cese-dci/tp-pseverini84/Informacion/schOriginal.pdf

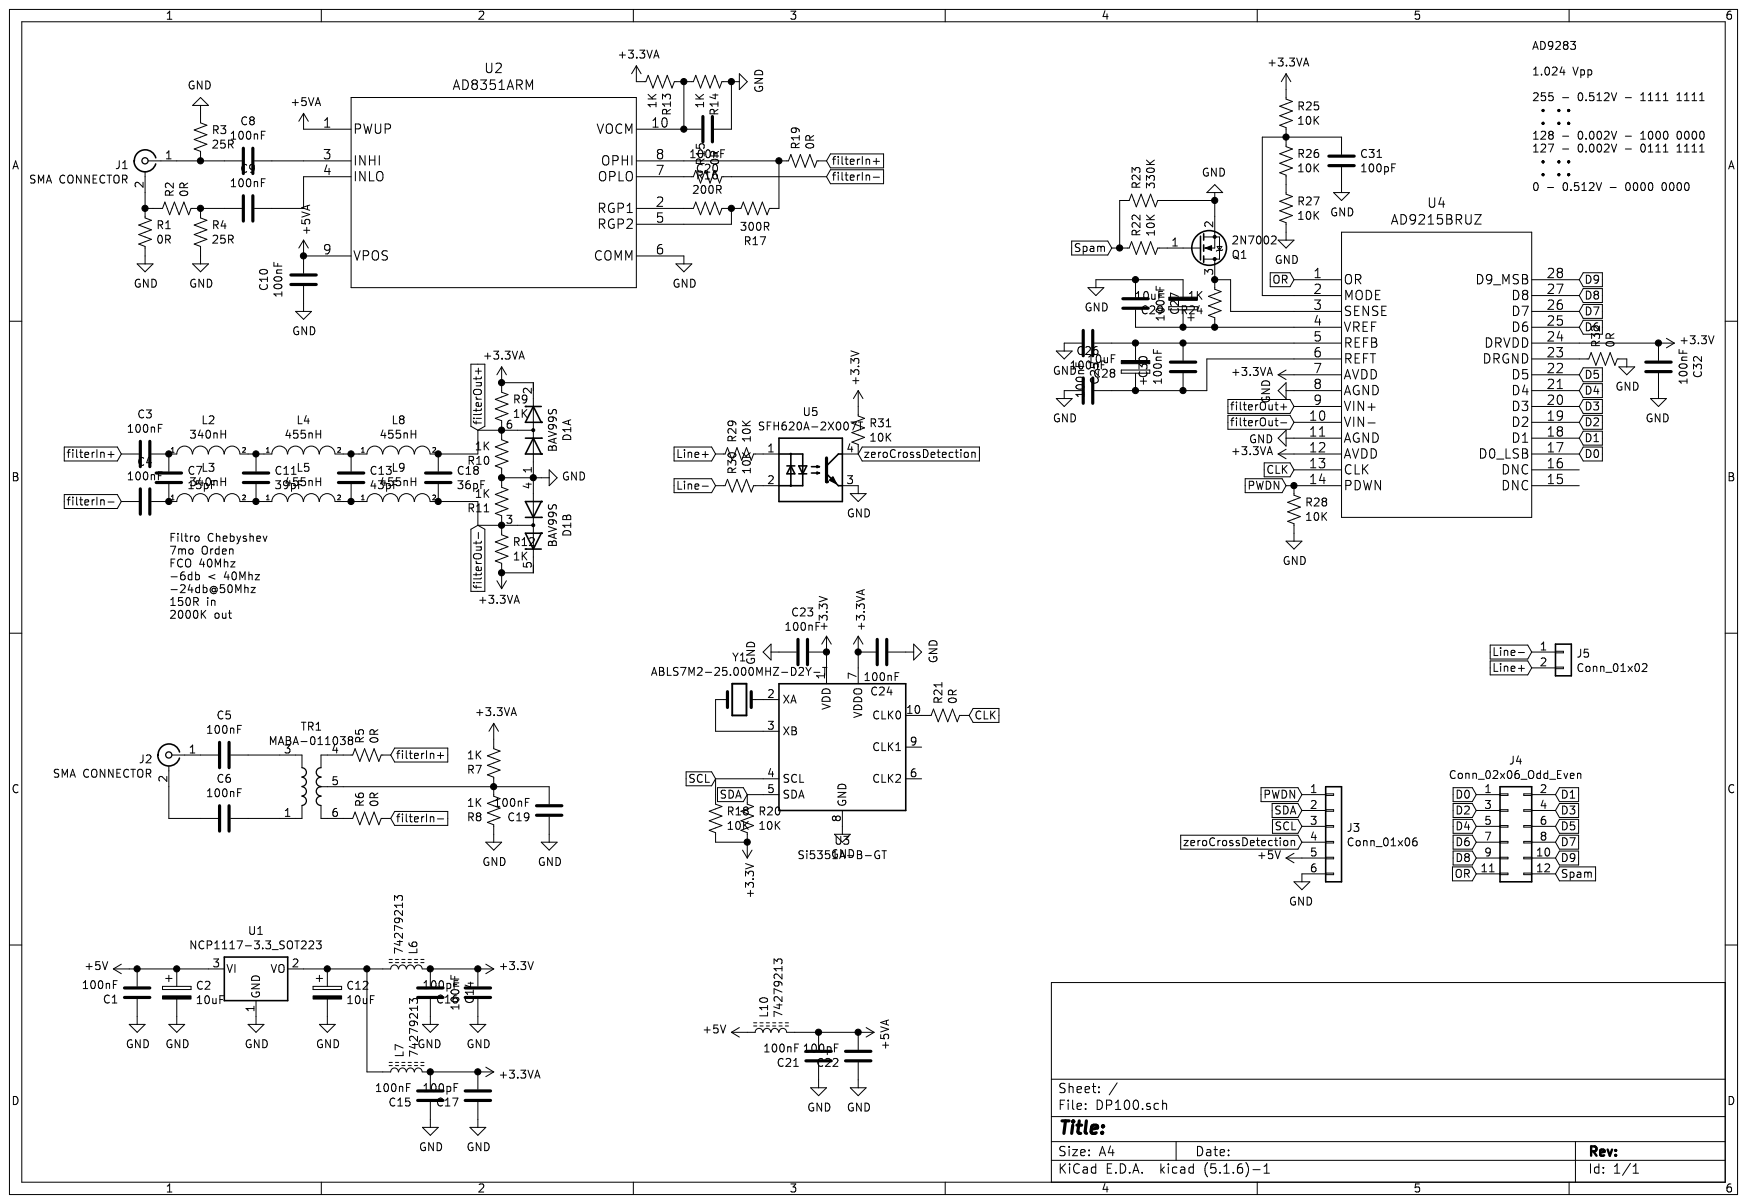
[picture p1: page 1]
