cese-dci/tp-pseverini84/DP100.kicad_pcb

## KiCad design DP100.kicad_pcb (2021-04-20)

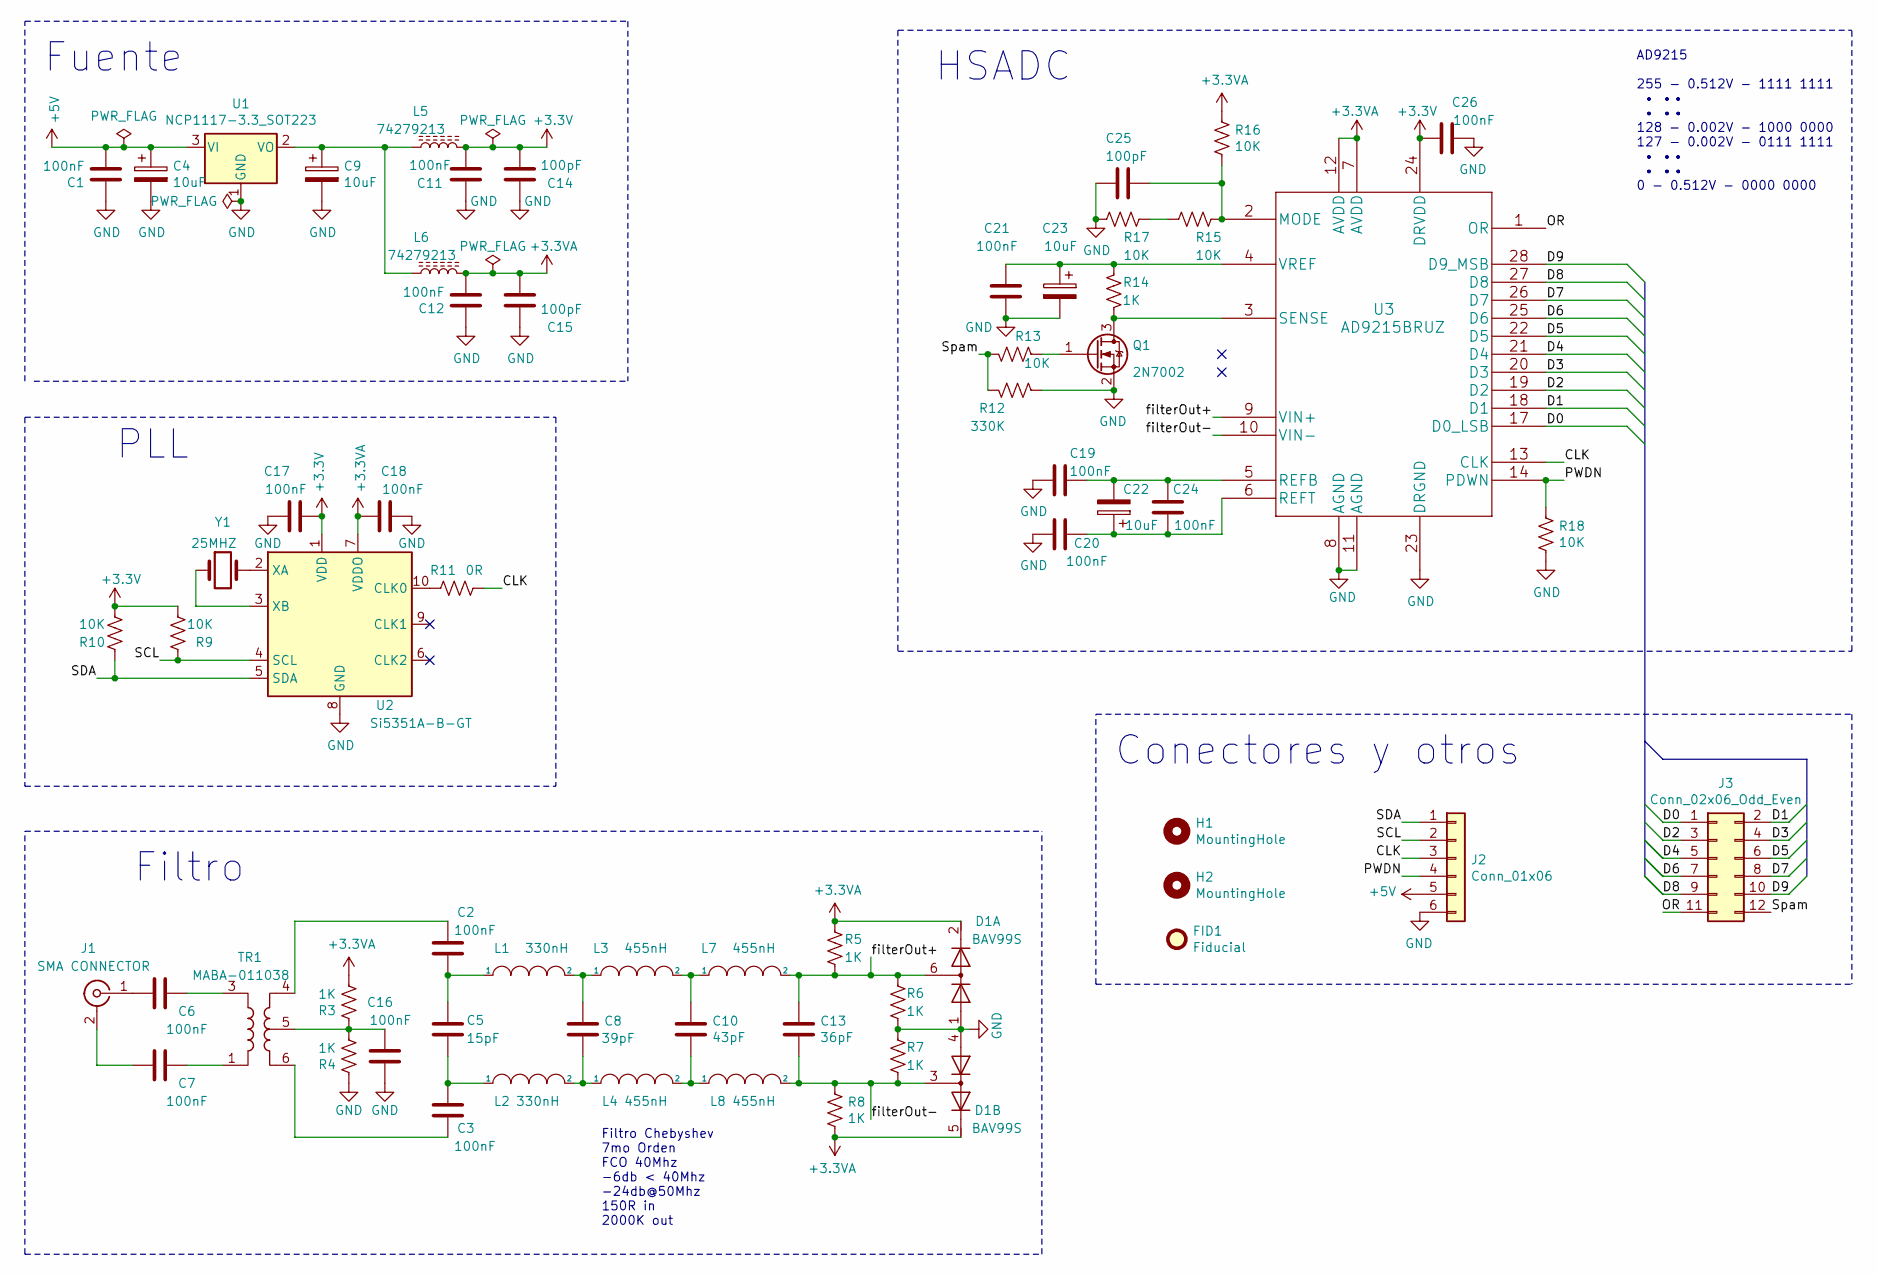
[picture p2: schematic DP100.sch, High speed ADC breakout]

Parts:
C1, C2, C3, C6, C7, C11, C12, C16, C17, C18, C19, C20, C21, C24, C26: 100nF; C_0603_1608Metric_Pad1.05x0.95mm_HandSolder; Mouser 80-C0603C104Z3V
C4, C9, C22, C23: 10uF; CP_EIA-2012-15_AVX-P_Pad1.30x1.05mm_HandSolder; Mouser 647-F920J106MPA
C5: 15pF; C_0603_1608Metric_Pad1.05x0.95mm_HandSolder; Mouser 710-885012006033
C8: 39pF; C_0603_1608Metric_Pad1.05x0.95mm_HandSolder; Mouser 80-C0603C390J5GAC
C10: 43pF; C_0603_1608Metric_Pad1.05x0.95mm_HandSolder; Mouser 603-CC603JRNPO9BN430
C13: 36pF; C_0603_1608Metric_Pad1.05x0.95mm_HandSolder; Mouser 603-CC603JRNPO9BN360
C14, C15, C25: 100pF; C_0603_1608Metric_Pad1.05x0.95mm_HandSolder; Mouser 80-C0603C101K1HACTU
D1: BAV99S; SOT-363_SC-70-6; Mouser 771-BAV99S-T/R
FID1: Fiducial; Fiducial_0.5mm_Mask1mm
H1, H2: MountingHole; MountingHole_3mm
J1: SMA CONNECTOR; SMA_Amphenol_901-144_Vertical; Mouser 471-SMARACONNECTOR
J2: Conn_01x06; PinHeader_1x06_P2.54mm_Vertical; Mouser 855-M20-9754046
J3: Conn_02x06_Odd_Even; PinHeader_2x06_P2.54mm_Vertical; Mouser 855-M20-9760642
L1, L2: 330nH; L_1206_3216Metric_Pad1.42x1.75mm_HandSolder; Mouser 963-LBM2016TR33JV
L3, L4, L7, L8: 455nH; L_0805_2012Metric_Pad1.15x1.40mm_HandSolder; Mouser 963-BRC1608TR45M
L5, L6: 74279213; C_1206_3216Metric_Pad1.42x1.75mm_HandSolder; Mouser 710-74279213
Q1: 2N7002; SOT-23; Mouser 512-2N7002
R3, R4, R5, R6, R7, R8, R14: 1K; R_0603_1608Metric_Pad1.05x0.95mm_HandSolder; Mouser 71-CRCW06031K00FKEAC
R9, R10, R13, R15, R16, R17, R18: 10K; R_0603_1608Metric_Pad1.05x0.95mm_HandSolder; Mouser 71-CRCW0603-10K-E3
R11: 0R; R_0603_1608Metric_Pad1.05x0.95mm_HandSolder; Mouser 603-AC0603JR-130RL
R12: 330K; R_0603_1608Metric_Pad1.05x0.95mm_HandSolder; Mouser 603-RC0603FR-07330KL
TR1: MABA-011038; Mini-Circuits_DB1627; Mouser 937-MABA-011038
U1: NCP1117-3.3_SOT223; SOT-223-3_TabPin2; Mouser 863-NCP1117ST33T3G
U2: Si5351A-B-GT; MSOP-10_3x3mm_P0.5mm; Mouser 634-SI5351A-B-GTR
U3: AD9215BRUZ; TSSOP-28_4.4x9.7mm_P0.65mm; Mouser 584-AD9215BRUZ-105
Y1: 25MHZ; Crystal_SMD_ECS_CSM3X-2Pin_7.6x4.1mm; Mouser 815-ABLS7M225MHZD2YT

Connections:
+3.3VA: C12.2, C15.2, C18.1, D1.2 (K2), D1.5 (K4), L6.2, R3.2, R5.1, R8.2, R16.1, U2.7 (VDDO), U3.7 (AVDD), U3.12 (AVDD)
+3V3: C11.1, C14.2, C17.1, C26.2, L5.1, R9.2, R10.2, U2.1 (VDD), U3.24 (DRVDD)
+5V: C1.2, C4.1, J2.5, U1.3 (VI)
/CLK: J2.3, R11.2, U3.13 (CLK)
/D0: J3.1, U3.17 (D0_LSB)
/D1: J3.2, U3.18 (D1)
/D2: J3.3, U3.19 (D2)
/D3: J3.4, U3.20 (D3)
/D4: J3.5, U3.21 (D4)
/D5: J3.6, U3.22 (D5)
/D6: J3.7, U3.25 (D6)
/D7: J3.8, U3.26 (D7)
/D8: J3.9, U3.27 (D8)
/D9: J3.10, U3.28 (D9_MSB)
/OR: J3.11, U3.1 (OR)
/PWDN: J2.4, R18.1, U3.14 (PDWN)
/SCL: J2.2, R9.1, U2.4 (SCL)
/SDA: J2.1, R10.1, U2.5 (SDA)
/Spam: J3.12, R12.1, R13.1
/filterOut+: C13.1, D1.6 (K3A4), L7.2, R5.2, R6.2, U3.9 (VIN+)
/filterOut-: C13.2, D1.3 (K1A2), L8.2, R7.1, R8.1, U3.10 (VIN-)
GND: C1.1, C4.2, C9.2, C11.2, C12.1, C14.1, C15.1, C16.1, C17.2, C18.2, C19.2, C20.2, C21.2, C23.2, C25.2, C26.1, D1.1 (A1), D1.4 (A3), J2.6, Q1.2 (S), R4.1, R6.1, R7.2, R12.2, R17.2, R18.2, U1.1 (GND), U2.8 (GND), U3.8 (AGND), U3.11 (AGND), U3.23 (DRGND)
unnamed: C2.1, C5.1, L1.1
unnamed: C2.2, TR1.4
unnamed: C3.1, C5.2, L2.1
unnamed: C3.2, TR1.6
unnamed: C6.1, TR1.3
unnamed: C6.2, J1.1 (In)
unnamed: C7.1, TR1.1
unnamed: C7.2, J1.2 (Ext)
unnamed: C8.1, L1.2, L3.1
unnamed: C8.2, L2.2, L4.1
unnamed: C9.1, L5.2, L6.1, U1.2 (VO)
unnamed: C10.1, L3.2, L7.1
unnamed: C10.2, L4.2, L8.1
unnamed: C16.2, R3.1, R4.2, TR1.5
unnamed: C19.1, C22.2, C24.1, U3.5 (REFB)
unnamed: C20.1, C22.1, C24.2, U3.6 (REFT)
unnamed: C21.1, C23.1, R14.1, U3.4 (VREF)
unnamed: C25.1, R15.1, R16.2, U3.2 (MODE)
unnamed: Q1.1 (G), R13.2
unnamed: Q1.3 (D), R14.2, U3.3 (SENSE)
unnamed: R11.1, U2.10 (CLK0)
unnamed: R15.2, R17.1
unnamed: U2.2 (XA), Y1.2
unnamed: U2.3 (XB), Y1.1

Notes on the sheet:
Fuente
Conectores y otros
AD9215 255 - 0.512V - 1111 1111 • •• • •• 128 - 0.002V - 1000 0000 127 - 0.002V - 0111 1111 • •• • •• 0 - 0.512V - 0000 0000
HSADC
Filtro
PLL
Filtro Chebyshev 7mo Orden FCO 40Mhz -6db < 40Mhz -24db@50Mhz 150R in 2000K out

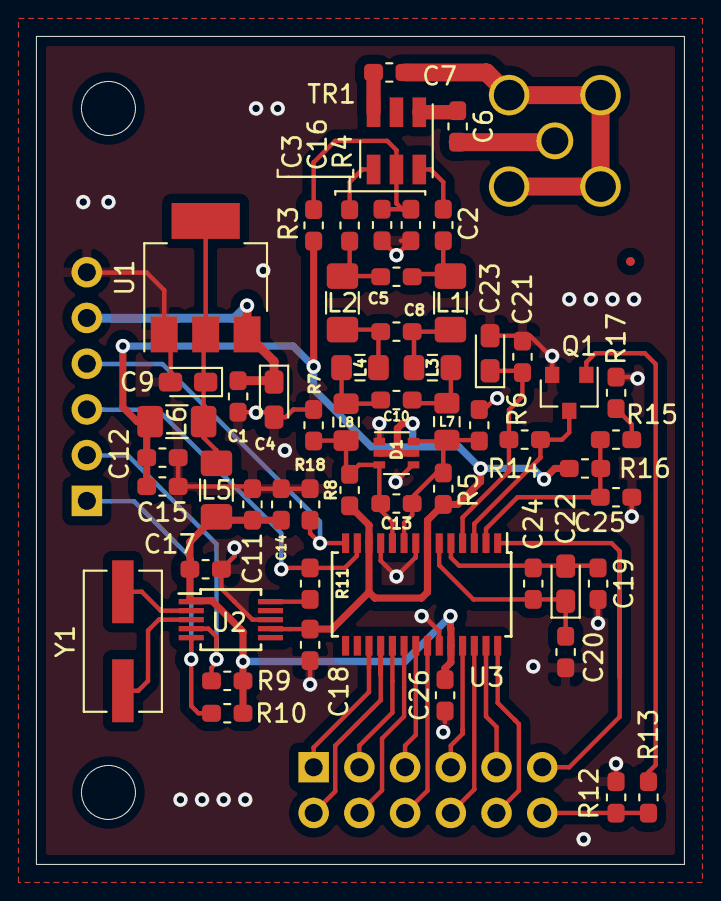
[picture p3: board DP100.kicad_pcb from above]

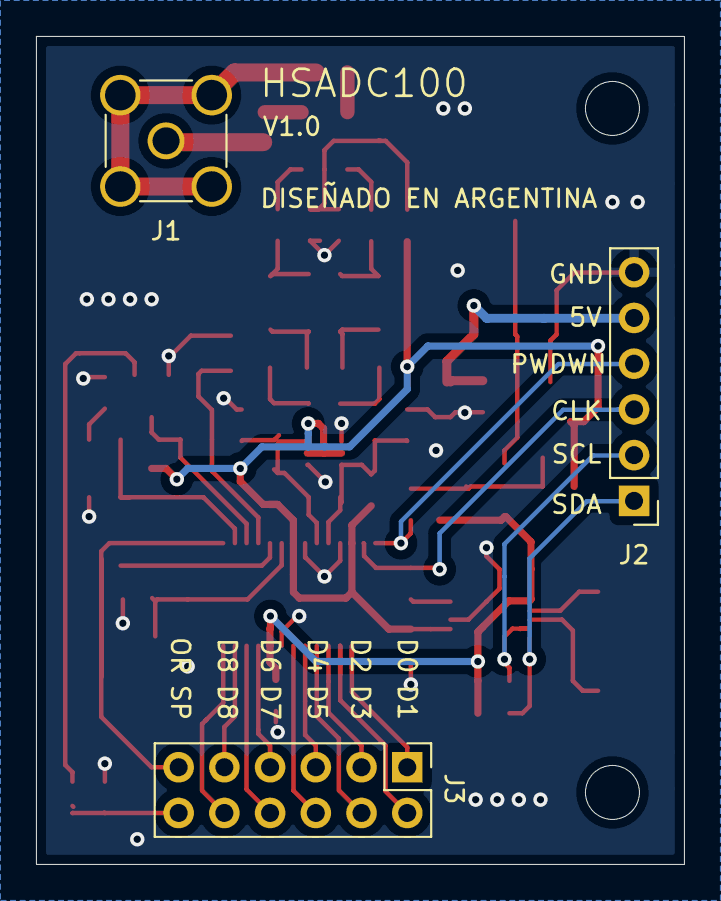
[picture p4: board DP100.kicad_pcb from below]

Board: 2 copper layers, 36.0 x 46.0 mm, 63 parts (3 on the bottom side), 46 nets.
