cese-dci/tp-pseverini84/(commit log)

2021-04-02 Se agrega esquematico para primera revision
    [DP100.kicad_pcb, DP100.sch, DP_Analogica.sch, DP_Fuente.sch, PD_Conector.sch, bom.csv, bom.xls]
2021-04-03 Correcciones realizadas sobre el esquematico a partir de la revision realizada el dia 2/4 por Francisco Timez
    [DP100.kicad_pcb, DP100.sch, DP_Analogica.sch, DP_Fuente.sch, PD_Conector.sch]
2021-04-03 Cambio de etiquetas globales por jerarquicas en el esquematico. Posicionamiento de componentes y ruteo de PCB
    [DP100.kicad_pcb, DP100.sch]
2021-04-03 Mascara de componentes posicionada correctamente Planos de tierra en ambas caras Reglas chequeadas segun fabricante Ernesto Mayer
    [DP100.kicad_pcb, DP100.sch]
2021-04-07 Se cambian las etiquetas jerarquicas por net labels.
    [DP100.kicad_pcb, DP100.sch]
2021-04-08 Se agregan cotas
    [DP100.kicad_pcb]
2021-04-09 Se agregan modelos 3d faltantes
    [DP100.kicad_pcb]
2021-04-10 Se agregan correcciones realizadas por Francisco Timez el dia 10-4 -Fiduciarios -Serigrafias faltantes -Otro agujero de sujecion
    [DP100.kicad_pcb, DP100.sch]
2021-04-12 Correcciones en base a devolucion de Diego Brengi del dia 12-4-2021 -Se expanden las zonas compactas -Se agrega directorio con informacion extra -Se agregan lineas para evitar que los labels toquen d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
    [DP100.kicad_pcb, DP100.sch, bom.csv, bom.xls]
2021-04-13 Se agrega rotulo en el pcb
    [DP100.kicad_pcb]
2021-04-13 Se agregan notas en PCB
    [DP100.kicad_pcb]
2021-04-20 Se realizan correcciones sugeridas el dia 20-4 -se agregan models 3d -se corrigen las notas -se modifican los planos de tierra segun sugerencia -se remueven serigrafias que se encontraban sobre vias 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
    [DP100.kicad_pcb]
