cese-dci/tp-pseverini84/(notices)

Notices in the files:
DP100.kicad_pcb:
Released under the Creative Commons Attribution Share-Alike 4.0 Licence
DP100.sch:
https://creativecommons.org/license/by-sa/4.0
